SWC-Advanced-Microscopy/Brainsaw_CAD/README.md

# Brainsaw CAD
CAD models for key BrainSaw parts.
For more details see the [BrainSaw project site](https://brainsaw.org).

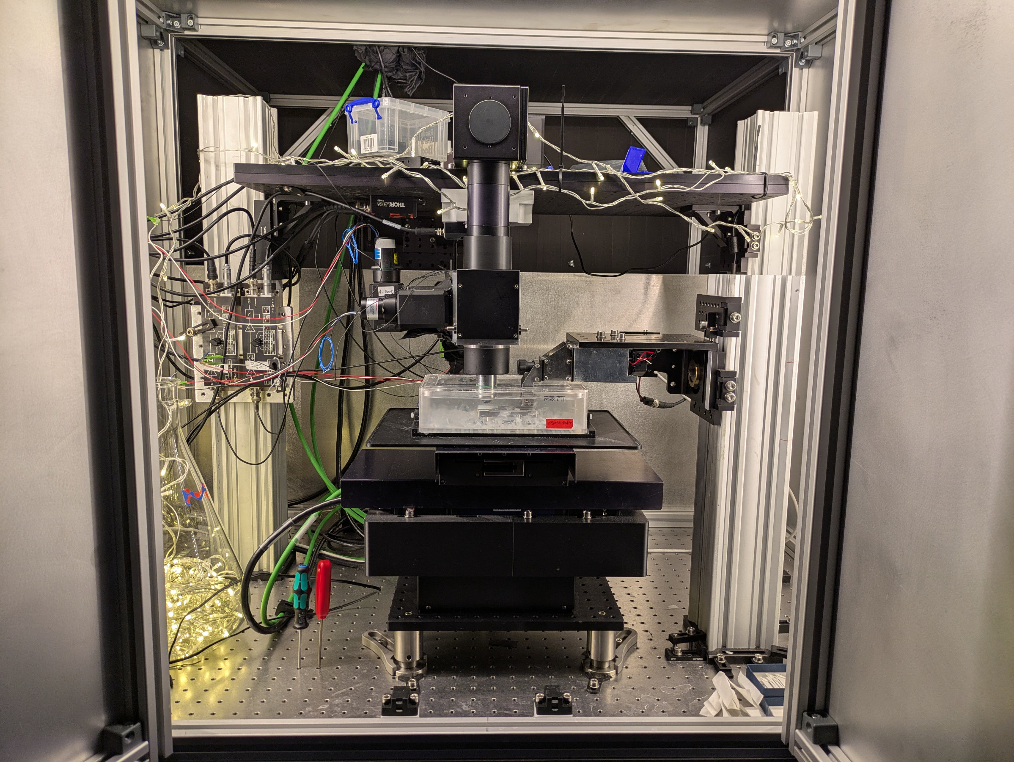
[picture p1: CAD/OG_System_Photo.jpg]
System photo
