SWC-Advanced-Microscopy/Brainsaw_CAD/CAD/Stages_And_Vibratome/README.md

# Stages and Vibratome CAD

This CAD model shows how PI V551 stages are coupled to a Prior Z-jack stage and associated with the vibratome pillar. 
Vibratome not shown.
