SWC-Advanced-Microscopy/Brainsaw_CAD/CAD/Water_Bath/Water_Bath_Readme.md

# BrainSaw Water-Bath

The water bath houses the sample during imaging. 
A pedestal in the centre has the sample clamped to it. 
Metal components should be machined from high quality stainless steel. 
Aluminium can work for the platform but will corode a little in the PB.
