SWC-Advanced-Microscopy/Brainsaw_CAD/CAD/Embedding/embedding_readme.md

# Embedding molds

The IPT files contain engraved brain images indicating how brains are to be mounted. These are not on the STP files.
