SWC-Advanced-Microscopy/Brainsaw_CAD/CAD/Splash_Guards/Splash_Guards_Readme.md

# Splash Guards

The V551 splash guards are made of aluminum and optionally anodised. They go over the stages to protect them from splashed PB.
