SWC-Advanced-Microscopy/Brainsaw_CAD/CAD/Embedding/Brain_embedding_mold_with_engraving.png

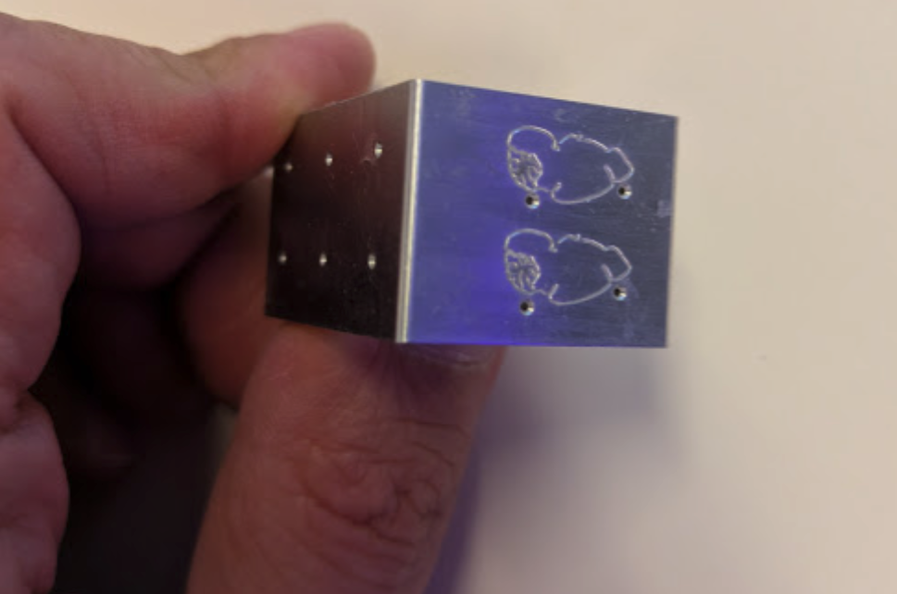
CAD/Embedding/Brain_embedding_mold_with_engraving.png
