SWC-Advanced-Microscopy/Brainsaw_CAD/CAD/Vibratome/dove_tail_clamp_02.jpg

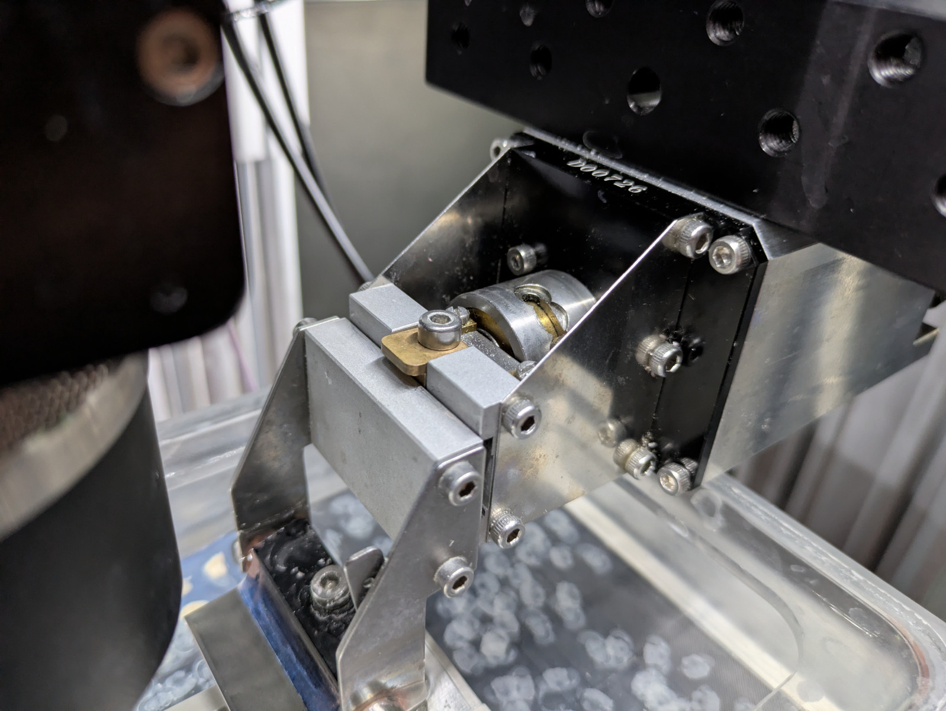
CAD/Vibratome/dove_tail_clamp_02.jpg
