SWC-Advanced-Microscopy/Brainsaw_CAD/CAD/Vibratome/right_angle_bushing.jpg

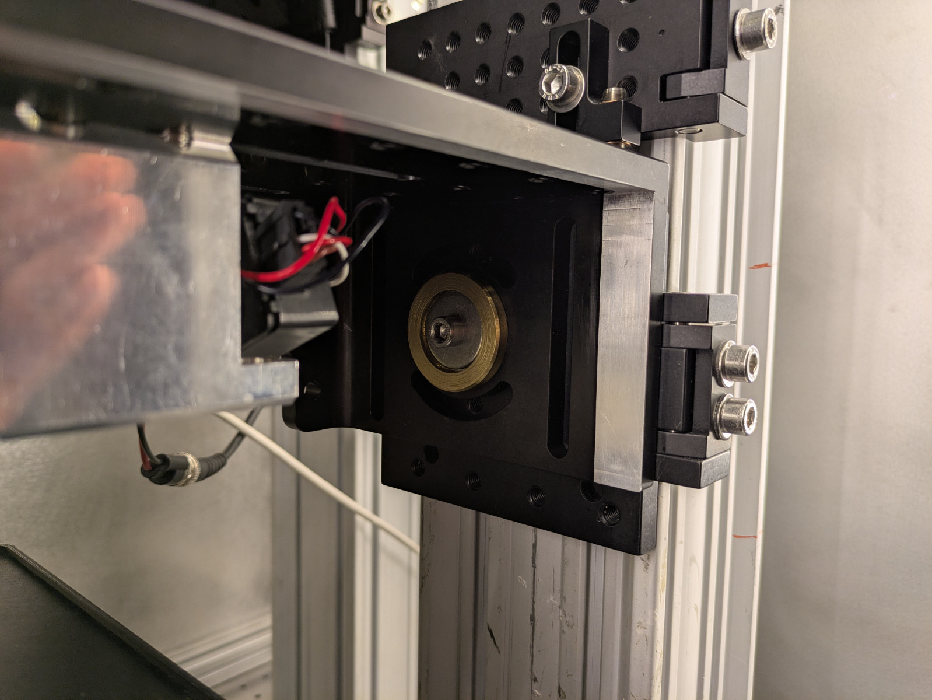
CAD/Vibratome/right_angle_bushing.jpg
