SWC-Advanced-Microscopy/Brainsaw_CAD/CAD/Vibratome/right_angle_bushing_02.jpg

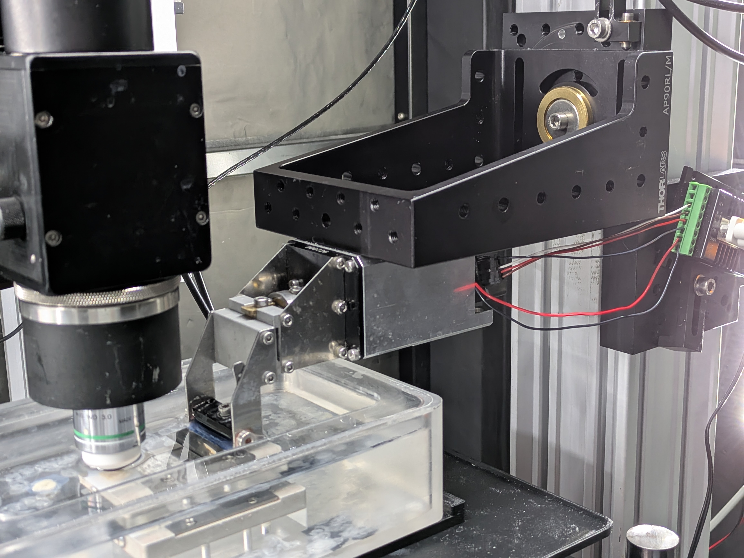
CAD/Vibratome/right_angle_bushing_02.jpg
