SWC-Advanced-Microscopy/Brainsaw_CAD/CAD/Vibratome/right_angle_bushing_03.jpg

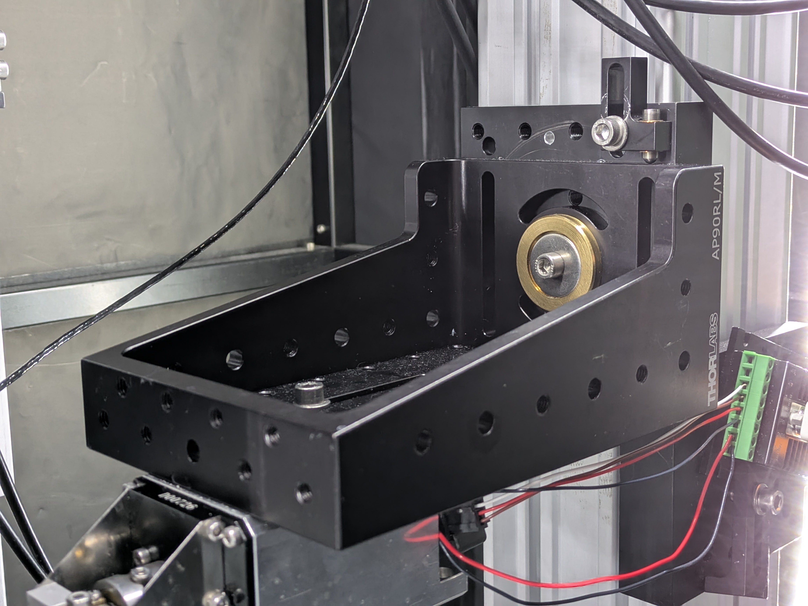
CAD/Vibratome/right_angle_bushing_03.jpg
