SWC-Advanced-Microscopy/Brainsaw_CAD/CAD/Vibratome/right_angle_bushing_05.jpg

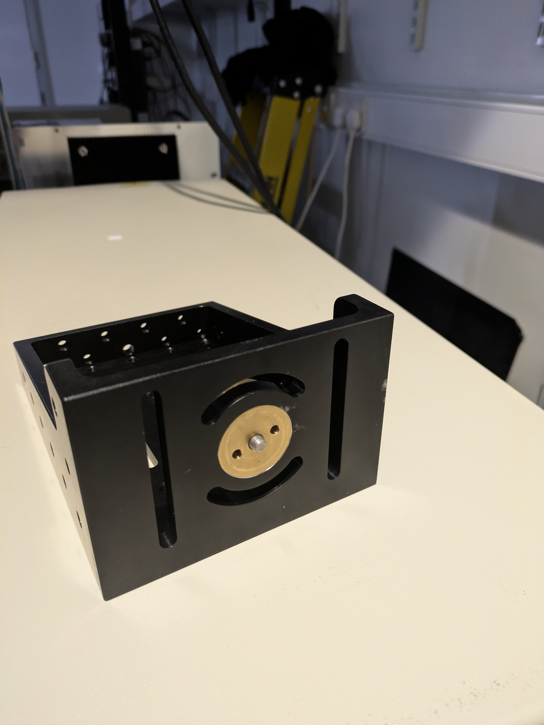
CAD/Vibratome/right_angle_bushing_05.jpg
