SWC-Advanced-Microscopy/Brainsaw_CAD/CAD/Water_Bath/water_bath_03.jpg

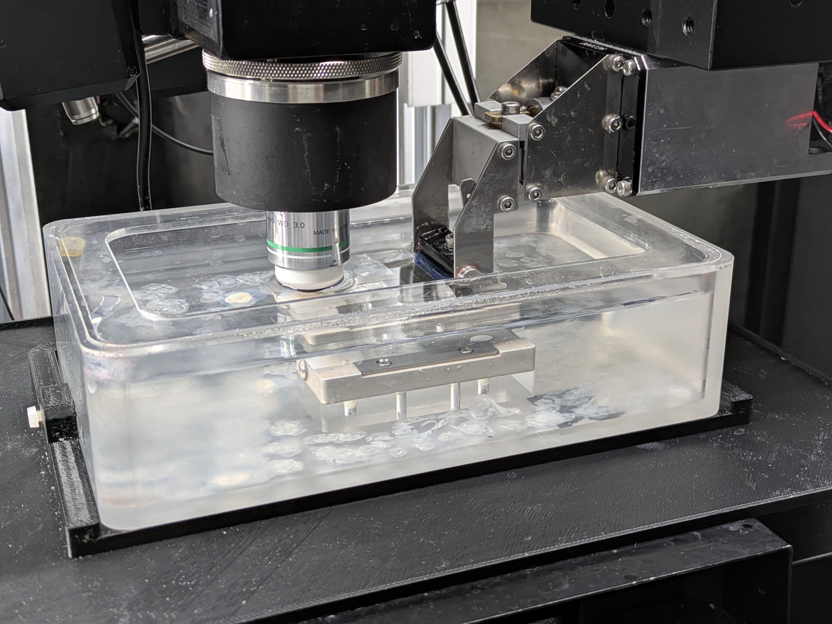
CAD/Water_Bath/water_bath_03.jpg
