SWC-Advanced-Microscopy/Brainsaw_CAD/CAD/Water_Bath/Water_Bath_Tray.jpg

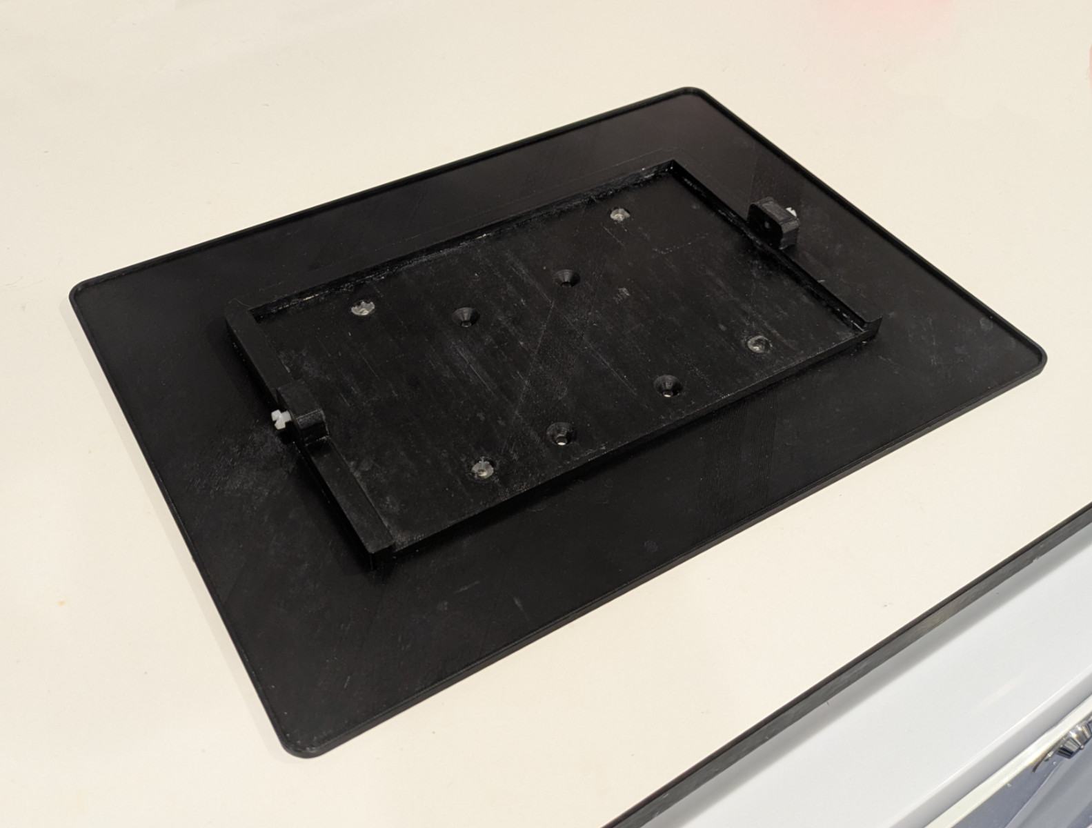
CAD/Water_Bath/Water_Bath_Tray.jpg
