SWC-Advanced-Microscopy/Brainsaw_CAD/CAD/Embedding/Embedding_Chamber_4_mouse_brains.stp

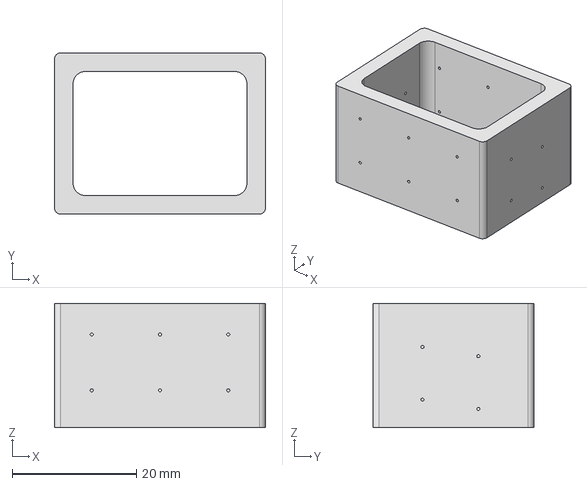
[picture p17: CAD file, 2026-03-27]
CAD/Embedding/Embedding_Chamber_4_mouse_brains.stp
34.0 x 26.0 x 20.0 mm
