SWC-Advanced-Microscopy/Brainsaw_CAD/CAD/Splash_Guards/Spash_Guard_PI_V551_4B.stp

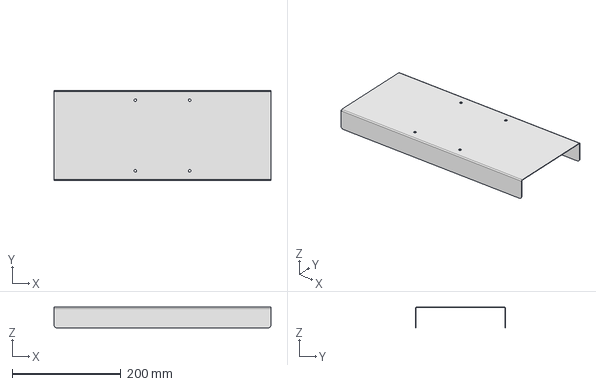
[picture p18: CAD file, 2026-03-27]
CAD/Splash_Guards/Spash_Guard_PI_V551_4B.stp
400.0 x 166.0 x 38.0 mm
