SWC-Advanced-Microscopy/Brainsaw_CAD/CAD/Vibratome/Vibratome_Clamp_Bushing.stp

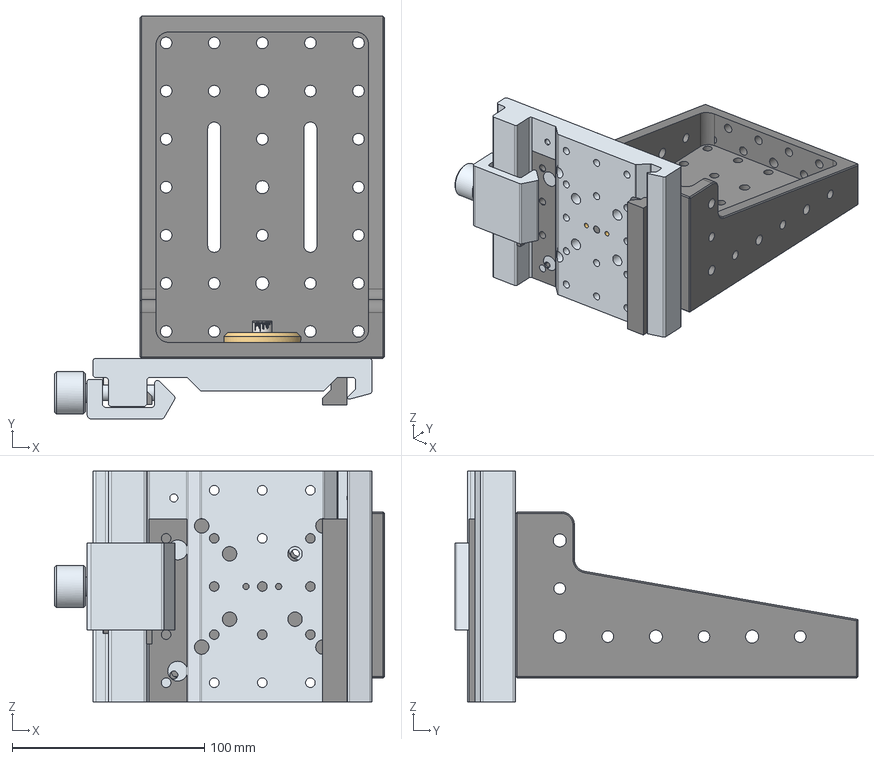
[picture p19: CAD file, 2026-03-27]
CAD/Vibratome/Vibratome_Clamp_Bushing.stp
171.5 x 209.3 x 120.0 mm
Newport-M-CXL95-120
TTN004341-E0W
AS 1420 - 1973 - M6 x 20
