SWC-Advanced-Microscopy/Brainsaw_CAD/CAD/Splash_Guards/Splash_Guard__V551_2B.stp

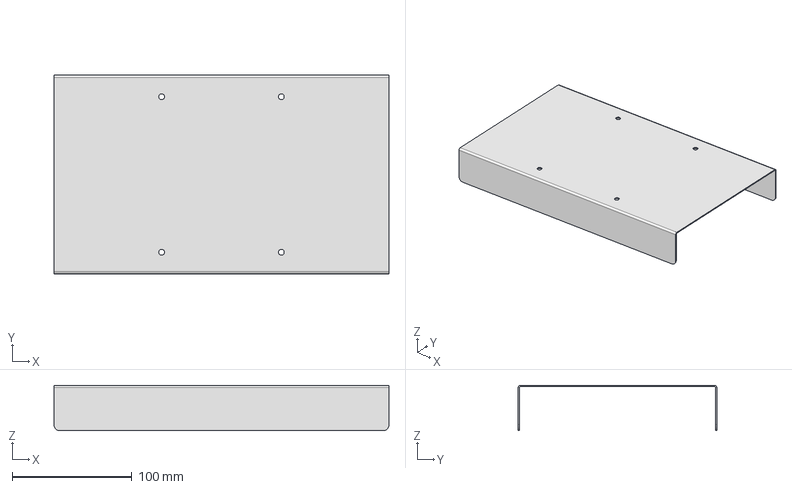
[picture p21: CAD file, 2026-03-27]
CAD/Splash_Guards/Splash_Guard__V551_2B.stp
280.0 x 166.0 x 38.0 mm
