SWC-Advanced-Microscopy/Brainsaw_CAD/CAD/Vibratome/Leica_VT1000_Dovetail_Bladehold_calamp.stp

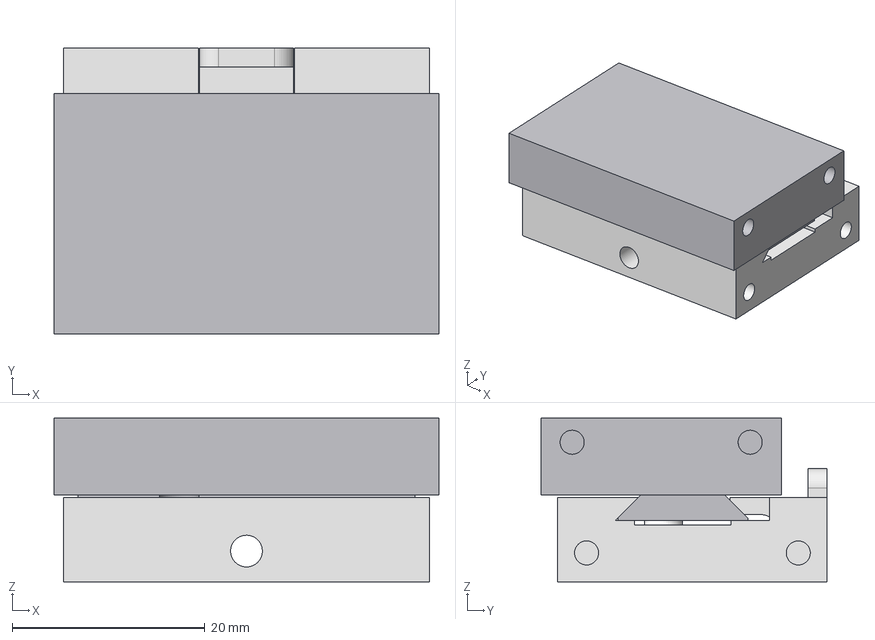
[picture p22: CAD file, 2026-03-27]
CAD/Vibratome/Leica_VT1000_Dovetail_Bladehold_calamp.stp
40.0 x 29.8 x 17.0 mm
Dovetail
Mount
Clamp
Pin
