SWC-Advanced-Microscopy/Brainsaw_CAD/CAD/Water_Bath/WaterBathHolder.stp

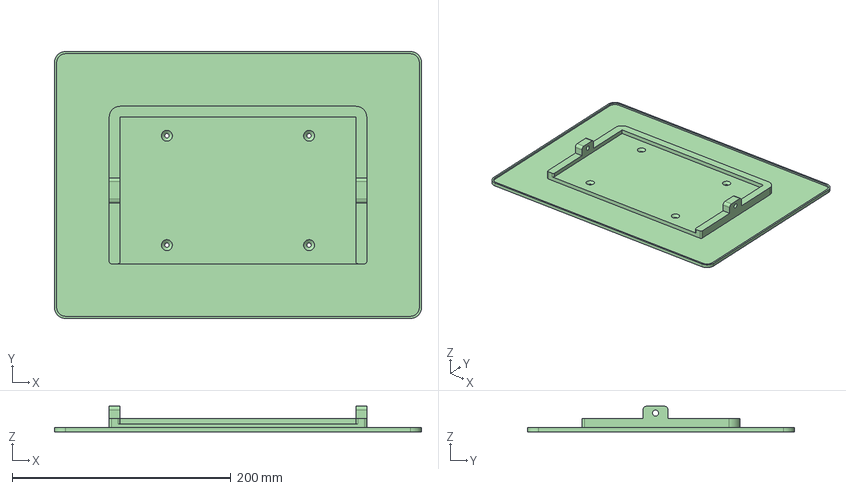
[picture p23: CAD file, 2026-03-27]
CAD/Water_Bath/WaterBathHolder.stp
335.5 x 244.0 x 23.5 mm
