SWC-Advanced-Microscopy/Brainsaw_CAD/(list of files, cad)

Other CAD files:
CAD/Embedding/Brain Embedding Chamber 1.ipt
CAD/Embedding/Brain Embedding Chamber 2.ipt
