SWC-Advanced-Microscopy/Brainsaw_CAD/(commit log)

2026-03-27 Add readme for BrainSaw Water-Bath
    Added a readme for the BrainSaw Water-Bath detailing its function and material requirements.
2026-03-27 Add header for Brainsaw CAD models
2026-03-27 Create README for V551 splash guards
    Added a README file for the V551 splash guards detailing their material and purpose.
2026-03-27 Create Vibratome CAD README with part descriptions
    Added a README file for the Vibratome CAD with details on optional parts and upgrades.
2026-03-27 Add README for embedding molds
2026-07-30 Add more photos of the right angle bushing
